TheUnknownAlias/betr_kicad_resources/README.md

# KiCad Component Library

This repository contains shared KiCad symbols and footprints for our projects.

## Structure
- `symbols/`: Contains schematic symbol libraries (.lib files)
- `footprints/`: Contains footprint libraries (.pretty folders)
- `3dmodels/`: Optional 3D models for components

## Usage
1. Clone this repository
2. In KiCad:
  - For symbols: Preferences → Manage Symbol Libraries → Add path to .lib files
  - For footprints: Preferences → Manage Footprint Libraries → Add path to .pretty folders

## Contributing
Please follow our contribution guidelines when adding new components.
