TheUnknownAlias/betr_kicad_resources/BOM_Files/Final_BOM.xls

Item # | Qty | Ref Des | Description/Value | MfgPartNum1 | Manufacturer 1 | MfgPartNum2 | Manufacturer 2 | MfgPartNum3 | Manufacturer 3 | Type
1 | 1 | C2001 | 4.7nF 0603 Form Factor Capacitor | 0603B472K500SD | NextGen Components |  |  |  |  | SMT
2 | 12 | C2002,C2005,C2007,C2008,C2009, C2013,C2019,C2024,C3001,C5001, C6001,C6002 | 100nF 0603 Form Factor Capacitor | 0603B104J500XD | Aillen |  |  |  |  | SMT
3 | 5 | C2003,C2017,C3002,C4003,C5002 | 10uF 0603 Form Factor Capacitor | 0603W106K6R3XD | NextGen Components |  |  |  |  | SMT
4 | 2 | C2004,C2023 | 10uF 25V 0603 Form Factor Capacitor | 0603W106M250XD | Aillen |  |  |  |  | SMT
5 | 2 | C2006,C2010 | 1 nF 0603 Form Factor Capacitor | 0603N102J500SD | NextGen Components |  |  |  |  | SMT
6 | 1 | C2020 | 22nF 0603 Form Factor Capacitor | 0603B223K500SD | NextGen Components |  |  |  |  | SMT
7 | 1 | C2022 | 1uF 0603 Form Factor Capacitor | 0603W105K100XD | Aillen |  |  |  |  | SMT
8 | 1 | C4002 | 22uF 0603 Form Factor Capacitor | 0603W226M6R3XD | Aillen |  |  |  |  | SMT
9 | 2 | C5003,C5004 | 10uF 16V 0603 Form Factor Capacitor | 0603W106M160XD | Aillen |  |  |  |  | SMT
10 | 1 | C2012 | 2.2uF 0603 Form Factor Capacitor | 0603W225K160XD | Aillen |  |  |  |  | SMT
11 | 2 | C2014,C2015 | 1uF 0603 Form Factor Capacitor | 0603B105K100XD | Aillen |  |  |  |  | SMT
12 | 1 | D2001 | Yellow LED | APT1608YC | Kingbright |  |  |  |  | SMT
13 | 1 | D2002 | Green LED | HSMG-C190 | Broadcom Limited |  |  |  |  | SMT
14 | 1 | D2003 | TVS DIODE 5.5VWM SOT143B | PRTR5V0U2X,215 | Nexperia USA Inc. |  |  |  |  | SMT
15 | 1 | D2004 | DIODE SCHOTTKY 60V 2A SOD123W | PMEG6020AELRX | Nexperia USA Inc. |  |  |  |  | SMT
16 | 1 | D3001 | Green LED 0603 Form Factor | 150060GS75000 | Würth Elektronik |  |  |  |  | SMT
17 | 1 | D6002 | Red LED 1206 Form Factor | LTST-C150EKT | Lite-On Inc. |  |  |  |  | SMT
18 | 1 | FL2001 | FERRITE BEAD 100 OHM 0603 1LN | BLM18EG101TN1D | Murata Electronics |  |  |  |  | SMT
19 | 1 | IC2001 | Step Down Converter | MP2322GQH-Z | Monolithic Power Systems Inc. |  |  |  |  | SMT
20 | 1 | J1003 | Connector: DC supply; socket; male; XT60; 30A; 500V; PIN: 2; on | XT60PW-M | AMASS |  |  |  |  | THT
21 | 1 | J2001 | USB2.0 MICRO AB SMD | ZX62-AB-5PA_31_ | Hirose Electric Co Ltd |  |  |  |  | SMT
22 | 1 | J6001 | CONN MICRO SD CARD R/A SMD | 2908-05WB-MG | 3M |  |  |  |  | SMT
23 | 1 | L2001 | FIXED IND 3.3UH 1.2A 255MOHM SMD | MAKK2016T3R3M | Taiyo Yuden |  |  |  |  | SMT
24 | 1 | LED2001 | LED RGB 0404 SMD | SMLP34RGBN1W3 | Rohm Semiconductor |  |  |  |  | SMT
25 | 1 | P1001 | TERM BLK 2P SIDE ENT 5.08MM PCB | 282837-2 | TE Connectivity AMP Connectors |  |  |  |  | THT
26 | 1 | R1002 | 100 0603 Form Factor Resistor | CR0603AFX-1000EAS | Bourns Inc. |  |  |  |  | SMT
27 | 1 | R1003 | 1.2k 0603 Form Factor Resistor | CR0603-FX-1201ELF | Bourns Inc. |  |  |  |  | SMT
28 | 1 | R2001 | 1M 0603 Form Factor Resistor | CR0603-FX-1004ELF | Bourns Inc. |  |  |  |  | SMT
29 | 2 | R2002,R2003 | 330 0603 Form Factor Resistor | CR0603-FX-3300ELF | Bourns Inc. |  |  |  |  | SMT
30 | 4 | R2006,R2009,R2013,R2014 | 976k 0603 Form Factor Resistor | CR0603-FX-9763ELF | Bourns Inc. |  |  |  |  | SMT
31 | 4 | R2007,R2011,R2012,R6001 | 1k 0603 Form Factor Resistor | CR0603AFX-1001EAS | Bourns Inc. |  |  |  |  | SMT
32 | 1 | R2008 | 220k 0603 Form Factor Resistor | CR0603-FX-2203ELF | Bourns Inc. |  |  |  |  | SMT
33 | 4 | R3001,R3002,R3003,R3004 | 4.7k 0603 Form Factor Resistor | CR0603-FX-4701ELF | Bourns Inc. |  |  |  |  | SMT
34 | 1 | R4002 | 19.1k 0603 Form Factor Resistor | CR0603-FX-1912ELF | Bourns Inc. |  |  |  |  | SMT
35 | 2 | R4003,R4004 | 100k 0603 Form Factor Resistor | CR0603AFX-1003EAS | Bourns Inc. |  |  |  |  | SMT
36 | 1 | R4005 | 53.6k 0603 Form Factor Resistor | CR0603-FX-5362ELF | Bourns Inc. |  |  |  |  | SMT
37 | 1 | SW2001 | Button | B3U-1000PM | Omron Electronics Inc-EMC Div |  |  |  |  | SMT
38 | 1 | U1005 | IC INST AMP 1 CIRCUIT 8DIP | AD623ANZ | Analog Devices |  |  |  |  | THT
39 | 1 | U2001 | Bluetooth® Low Energy 5.0 Module | NINA-B306-00B | u-blox |  |  |  |  | SMT
40 | 1 | U2002 | IMU Sensor | BMI270 | Bosch Sensortec |  |  |  |  | SMT
41 | 1 | U2003 | Magnetometer IC | BMM350 | Bosch Sensortec |  |  |  |  | SMT
42 | 1 | U2004 | MOSFET N-CH 60V 115MA SOT-523 | 2N7002T-7-F | Diodes Incorporated |  |  |  |  | SMT
43 | 1 | U3001 | IC DAC 12BIT V-OUT 10MSOP | MCP4728-E/UN | Microchip Technology |  |  |  |  | SMT
44 | 1 | U4001 | DC DC CONVERTER 0.8-18.48V | MPM3610GQV-P | Monolithic Power Systems Inc. |  |  |  |  | SMT
45 | 1 | U5001 | Stepper Motor Driver | DRV8833PWP | Texas Instruments |  |  |  |  | SMT
46 | 1 | U6001 | IC BUFFER NON-INVERT 6V 16-SOIC | CD74HC4050M96 | Texas Instruments |  |  |  |  | SMT
47 | 1 | U6002 | IC REG LINEAR 3.3V 150MA SOT23-5 | LP2985-33DBVR | Texas Instruments |  |  |  |  | SMT
48 | 1 | U2005 | IC REG LINEAR 1.8V 300MA SOT23-5 | TPS7A2018PDBVR | Texas Instruments |  |  |  |  | SMT
