TheUnknownAlias/betr_kicad_resources/KiCadFiles_Multimodal_Actuator_mk2/Multimodal_Actuator_mk2_mockup.step

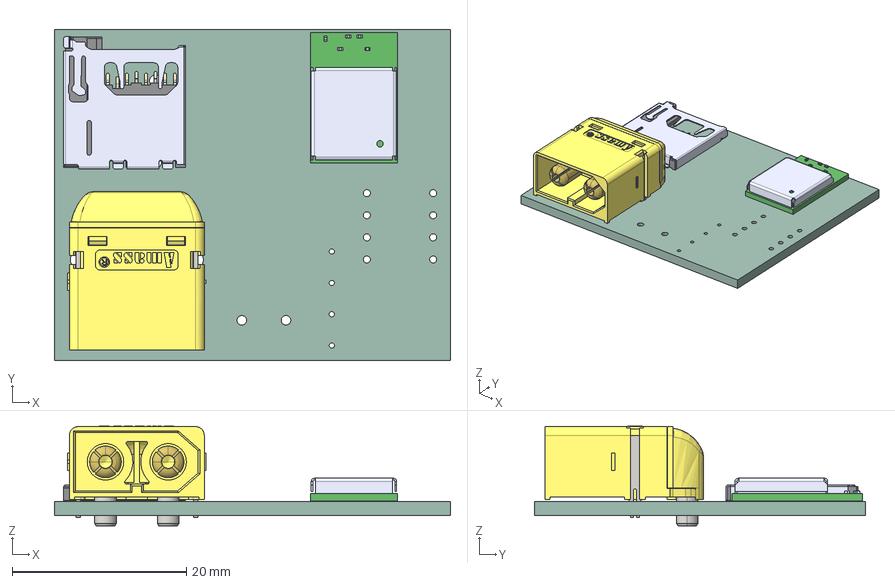
[picture p1: CAD file, 2025-09-09]
KiCadFiles_Multimodal_Actuator_mk2/Multimodal_Actuator_mk2_mockup.step
45.5 x 38.0 x 11.5 mm
2908-05WB-MG
NINA-B306-00B-00
XT60PW-M
_autosave-Multimodal_Actuator_mk2_PCB
