TheUnknownAlias/betr_kicad_resources/3dmodels/BMM150.STEP

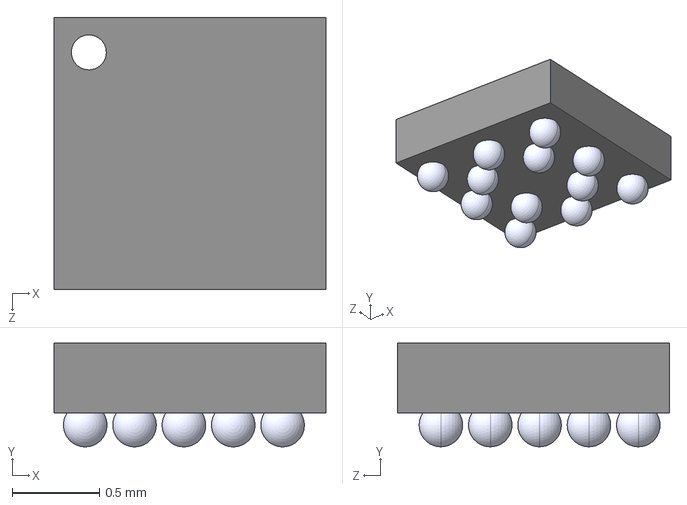
[picture p2: CAD file, 2025-09-09]
3dmodels/BMM150.STEP
1.56 x 0.595 x 1.56 mm
Body^BMM150
Pin^BMM150 x 12
