TheUnknownAlias/betr_kicad_resources/3dmodels/XT60PW-M.stp

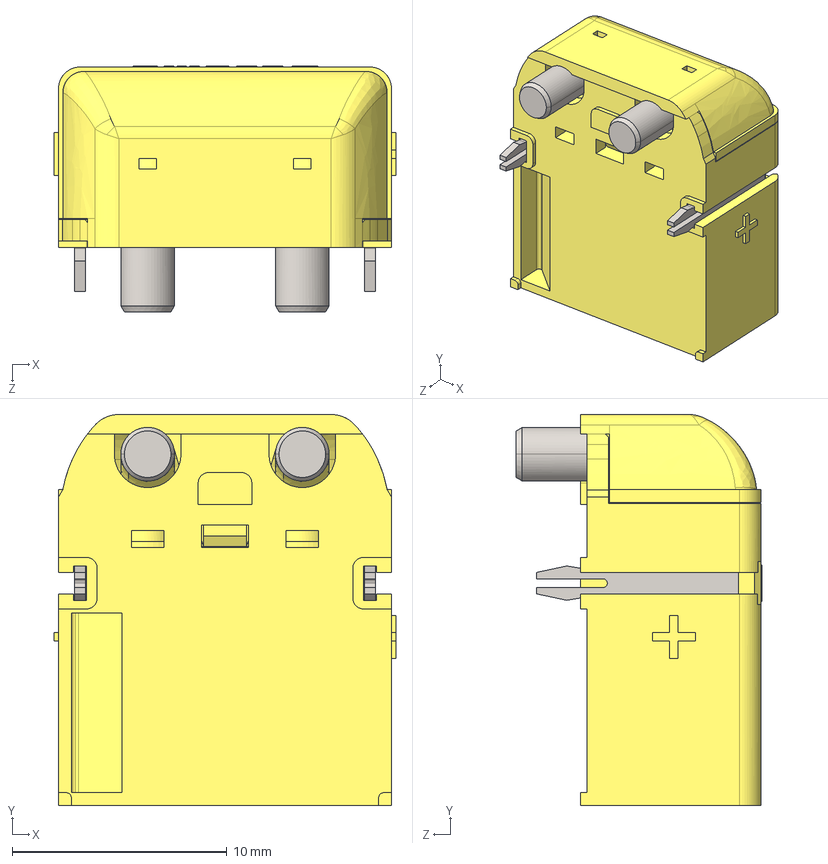
[picture p3: CAD file, 2025-09-09]
3dmodels/XT60PW-M.stp
15.9 x 18.2 x 11.5 mm
