TheUnknownAlias/betr_kicad_resources/3dmodels/BMI270.step

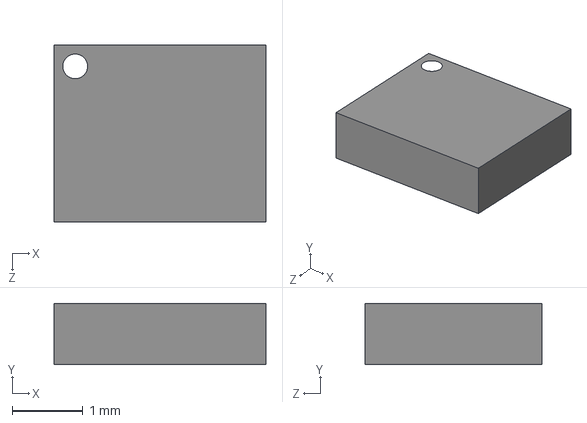
[picture p4: CAD file, 2025-09-09]
3dmodels/BMI270.step
3.00 x 0.87 x 2.50 mm
