TheUnknownAlias/betr_kicad_resources/3dmodels/MPM3606AGQV.step

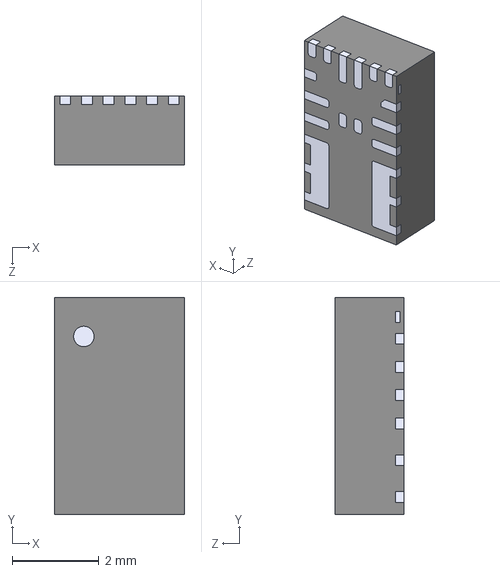
[picture p5: CAD file, 2025-09-09]
3dmodels/MPM3606AGQV.step
3.00 x 5.00 x 1.60 mm
