TheUnknownAlias/betr_kicad_resources/3dmodels/CD74HC4050M96.step

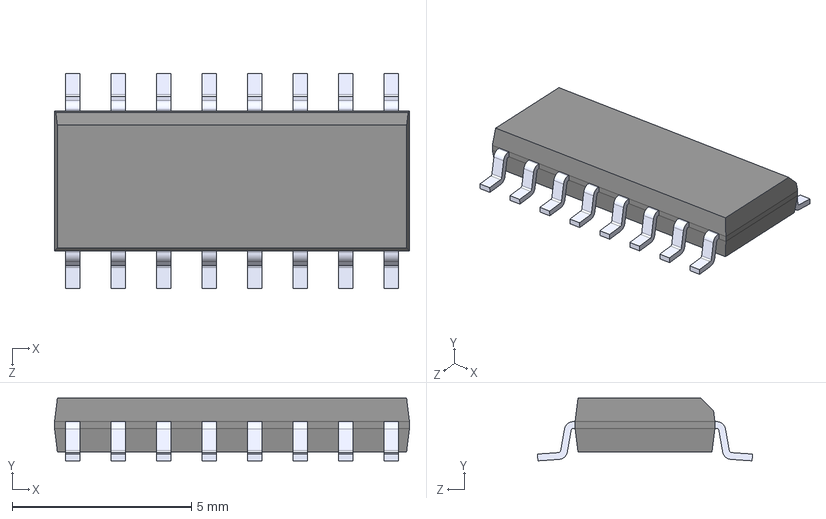
[picture p6: CAD file, 2025-09-09]
3dmodels/CD74HC4050M96.step
9.90 x 1.75 x 6.00 mm
