TheUnknownAlias/betr_kicad_resources/3dmodels/MP2322GQH-Z.stp

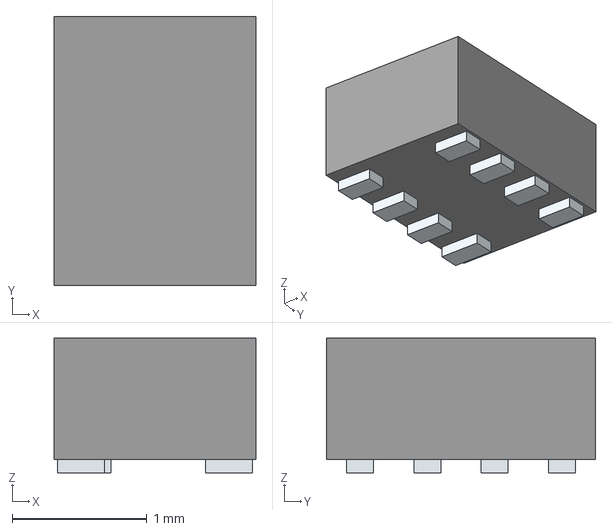
[picture p7: CAD file, 2025-09-09]
3dmodels/MP2322GQH-Z.stp
1.50 x 2.00 x 1.00 mm
Pins
