TheUnknownAlias/betr_kicad_resources/3dmodels/HSMG-C190.STEP

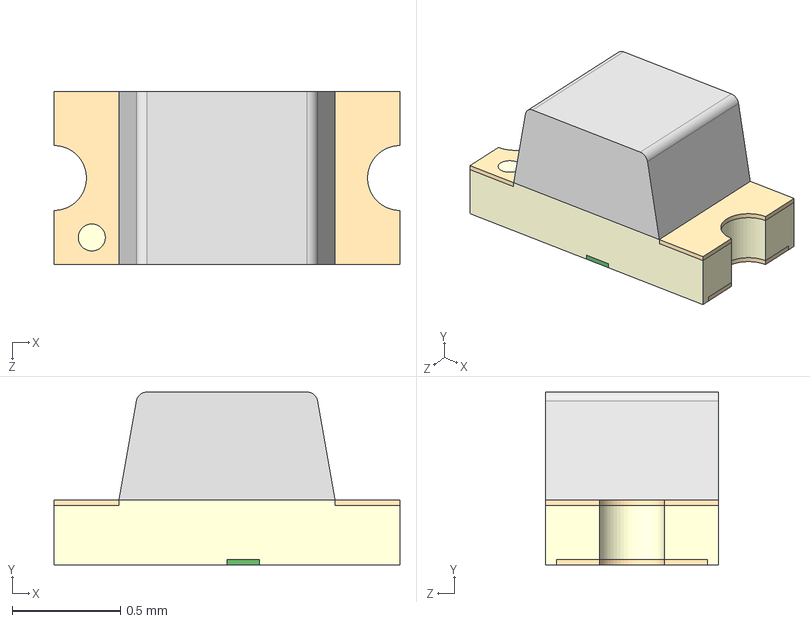
[picture p8: CAD file, 2025-09-09]
3dmodels/HSMG-C190.STEP
1.60 x 0.8 x 0.8 mm
