TheUnknownAlias/betr_kicad_resources/3dmodels/2N7002T-7-F.step

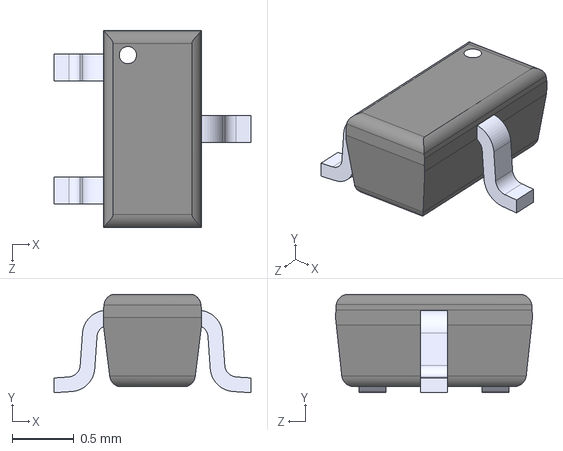
[picture p9: CAD file, 2025-09-09]
3dmodels/2N7002T-7-F.step
1.60 x 0.8 x 1.60 mm
