TheUnknownAlias/betr_kicad_resources/3dmodels/ZX62-AB-5PA(31).STEP

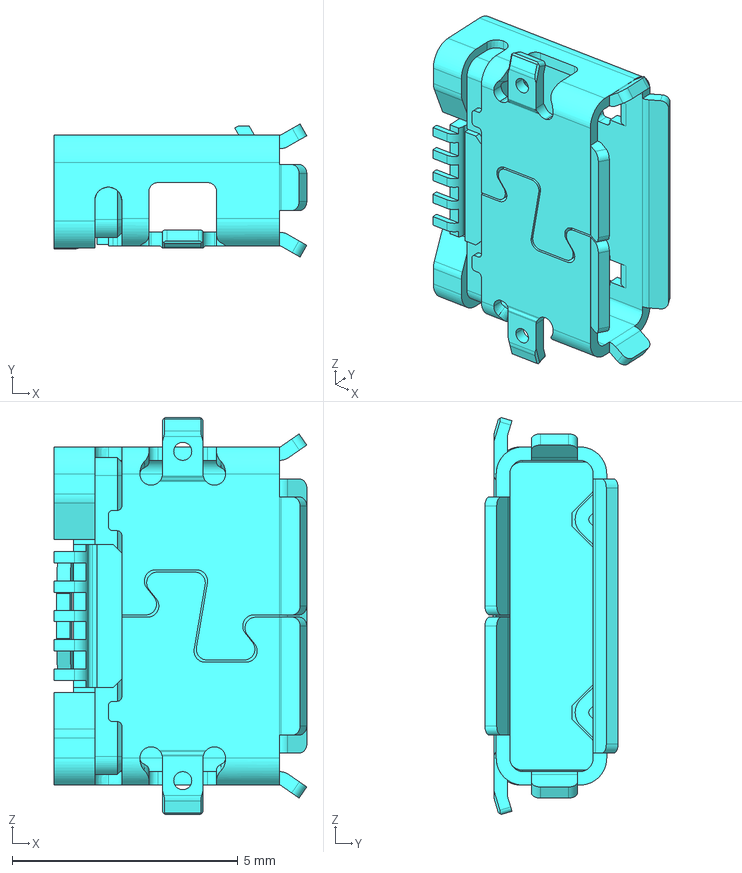
[picture p10: CAD file, 2025-09-09]
3dmodels/ZX62-AB-5PA(31).STEP
5.60 x 2.95 x 8.80 mm
