TheUnknownAlias/betr_kicad_resources/3dmodels/2908-05WB-MG.STEP

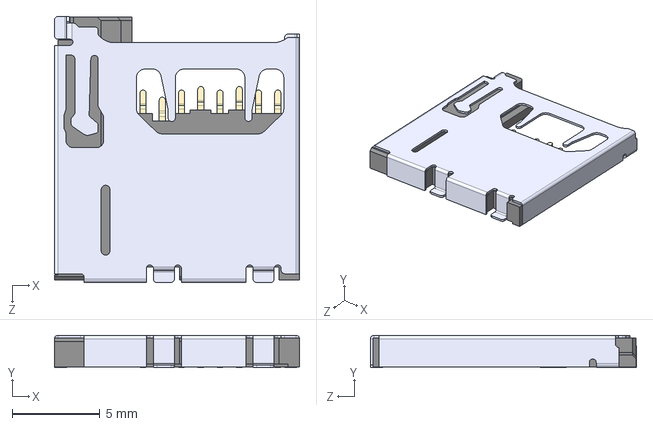
[picture p11: CAD file, 2025-09-09]
3dmodels/2908-05WB-MG.STEP
14.0 x 1.85 x 15.2 mm
