TheUnknownAlias/betr_kicad_resources/3dmodels/LP2985-33DBVR.step

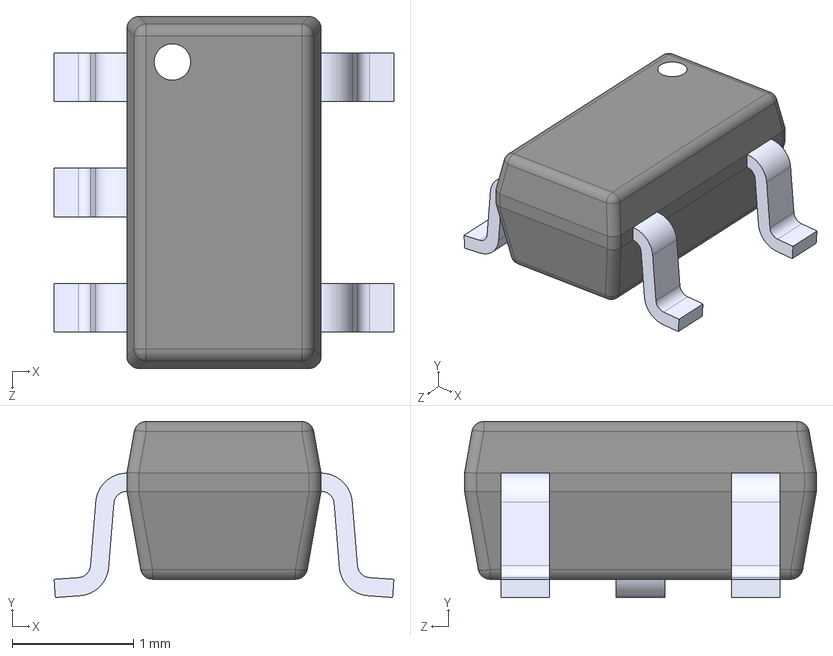
[picture p12: CAD file, 2025-09-09]
3dmodels/LP2985-33DBVR.step
2.80 x 1.45 x 2.90 mm
