TheUnknownAlias/betr_kicad_resources/3dmodels/APDS-9960.step

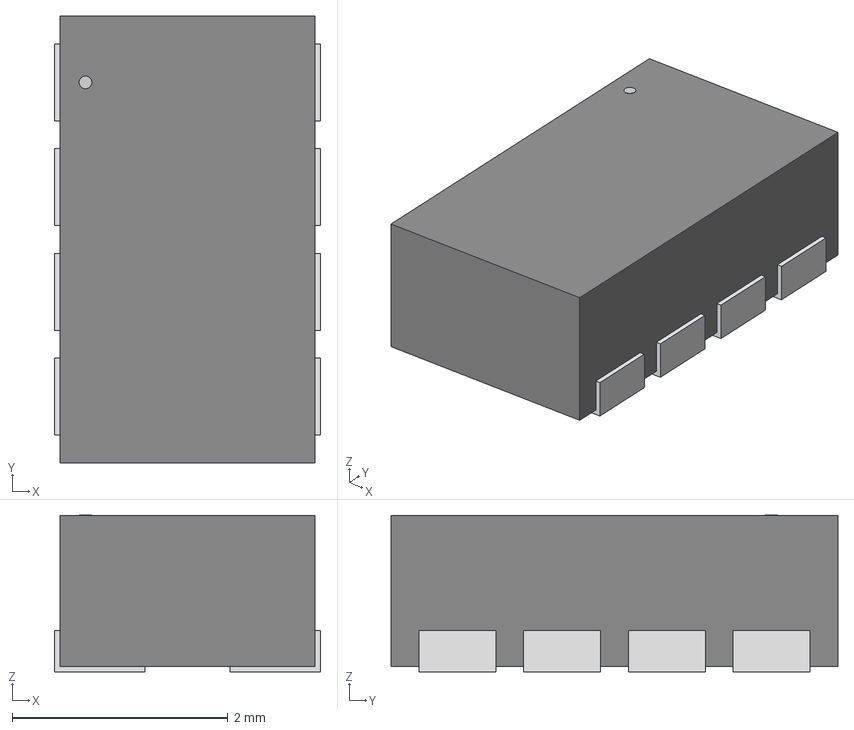
[picture p13: CAD file, 2025-09-09]
3dmodels/APDS-9960.step
2.46 x 4.14 x 1.45 mm
