TheUnknownAlias/betr_kicad_resources/3dmodels/B3U-1000PM_OMR.step

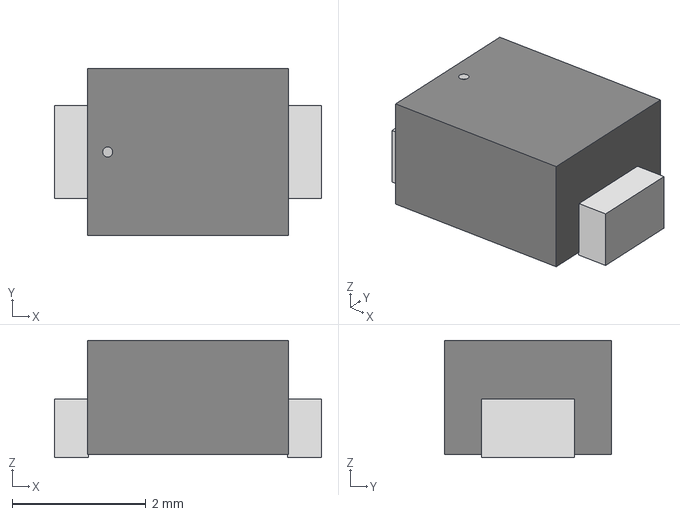
[picture p14: CAD file, 2025-09-09]
3dmodels/B3U-1000PM_OMR.step
3.99 x 2.49 x 1.75 mm
