TheUnknownAlias/betr_kicad_resources/3dmodels/NINA-B306-00B.step

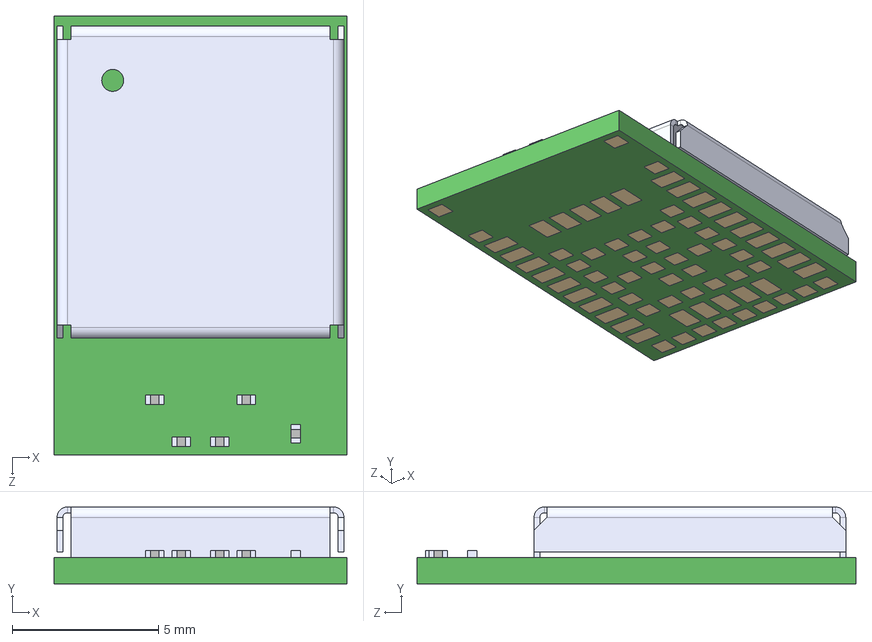
[picture p15: CAD file, 2025-09-09]
3dmodels/NINA-B306-00B.step
10.0 x 2.63 x 15.0 mm
