TheUnknownAlias/betr_kicad_resources/3dmodels/MAKK2016T3R3M.step

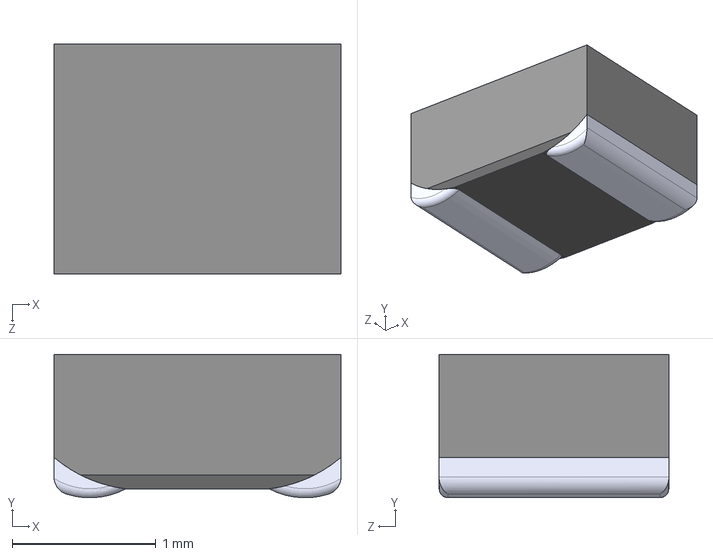
[picture p16: CAD file, 2025-09-09]
3dmodels/MAKK2016T3R3M.step
2.00 x 1 x 1.60 mm
