TheUnknownAlias/betr_kicad_resources/3dmodels/BEADC1608X65N.step

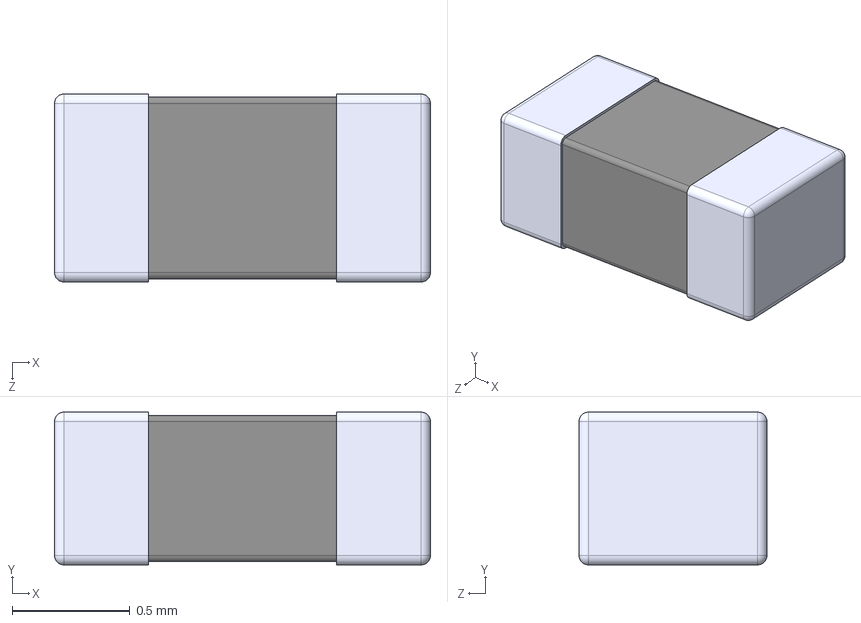
[picture p17: CAD file, 2025-09-09]
3dmodels/BEADC1608X65N.step
1.60 x 0.65 x 0.8 mm
