TheUnknownAlias/betr_kicad_resources/3dmodels/PMEG6020AELRX.step

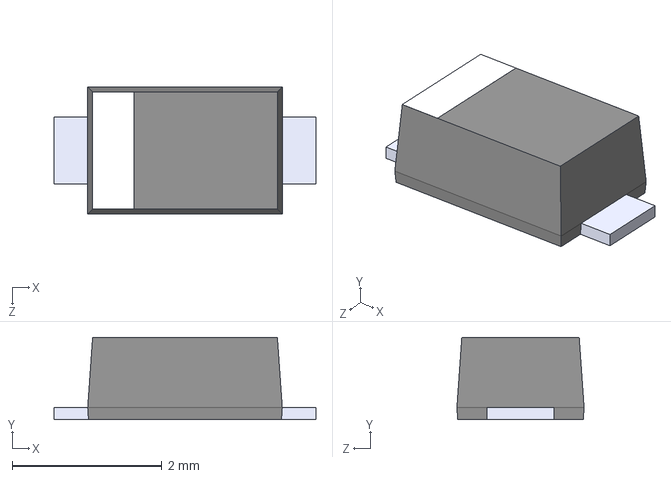
[picture p18: CAD file, 2025-09-09]
3dmodels/PMEG6020AELRX.step
3.50 x 1.10 x 1.70 mm
