TheUnknownAlias/betr_kicad_resources/3dmodels/MP34DT06JTR.STEP

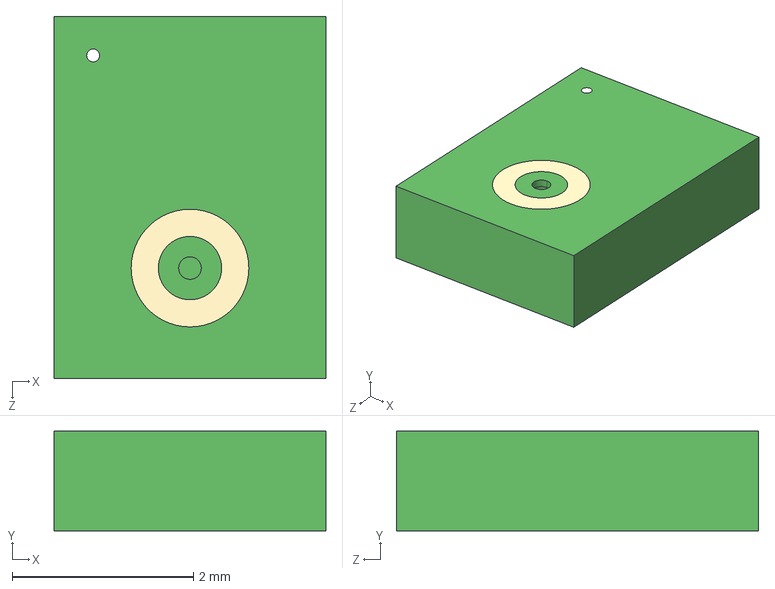
[picture p19: CAD file, 2025-09-09]
3dmodels/MP34DT06JTR.STEP
3.00 x 1.10 x 4.00 mm
