TheUnknownAlias/betr_kicad_resources/3dmodels/APT1608YC.STEP

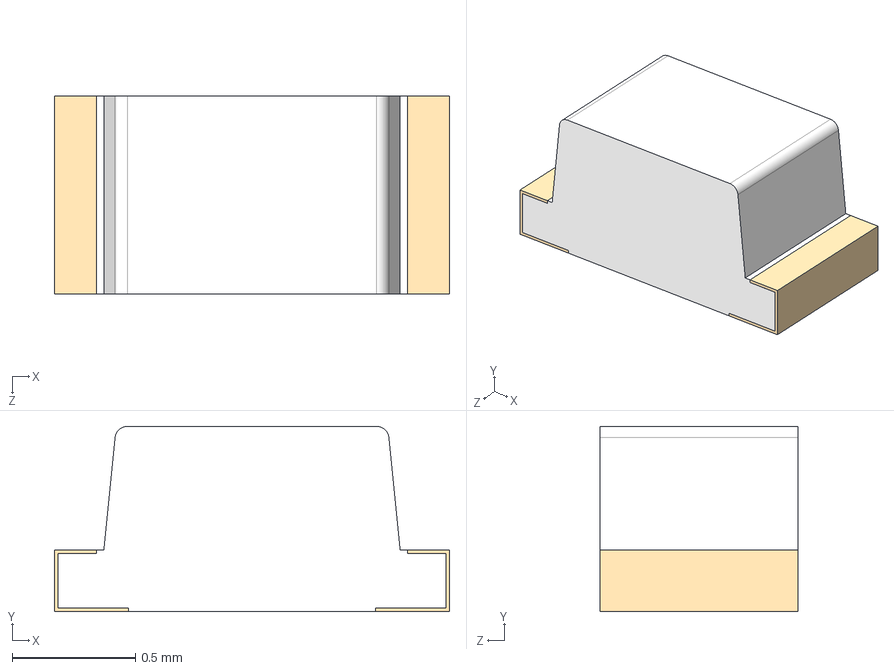
[picture p20: CAD file, 2025-09-09]
3dmodels/APT1608YC.STEP
1.60 x 0.75 x 0.8 mm
