TheUnknownAlias/betr_kicad_resources/3dmodels/LPS22HBTR.step

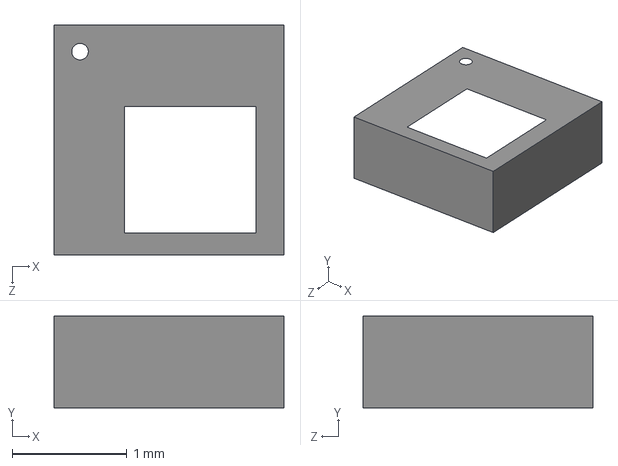
[picture p21: CAD file, 2025-09-09]
3dmodels/LPS22HBTR.step
2.00 x 0.8 x 2.00 mm
