TheUnknownAlias/betr_kicad_resources/(list of files, cad)

Other CAD files:
3dmodels/TPS7A2018PDBVR.step
3dmodels/282837-2.step
