TheUnknownAlias/betr_kicad_resources/KiCadFiles_Multimodal_Actuator_mk2/Multimodal_Actuator_mk2.kicad_pcb

## KiCad design KiCadFiles_Multimodal_Actuator_mk2/Multimodal_Actuator_mk2.kicad_pcb (2025-09-09)

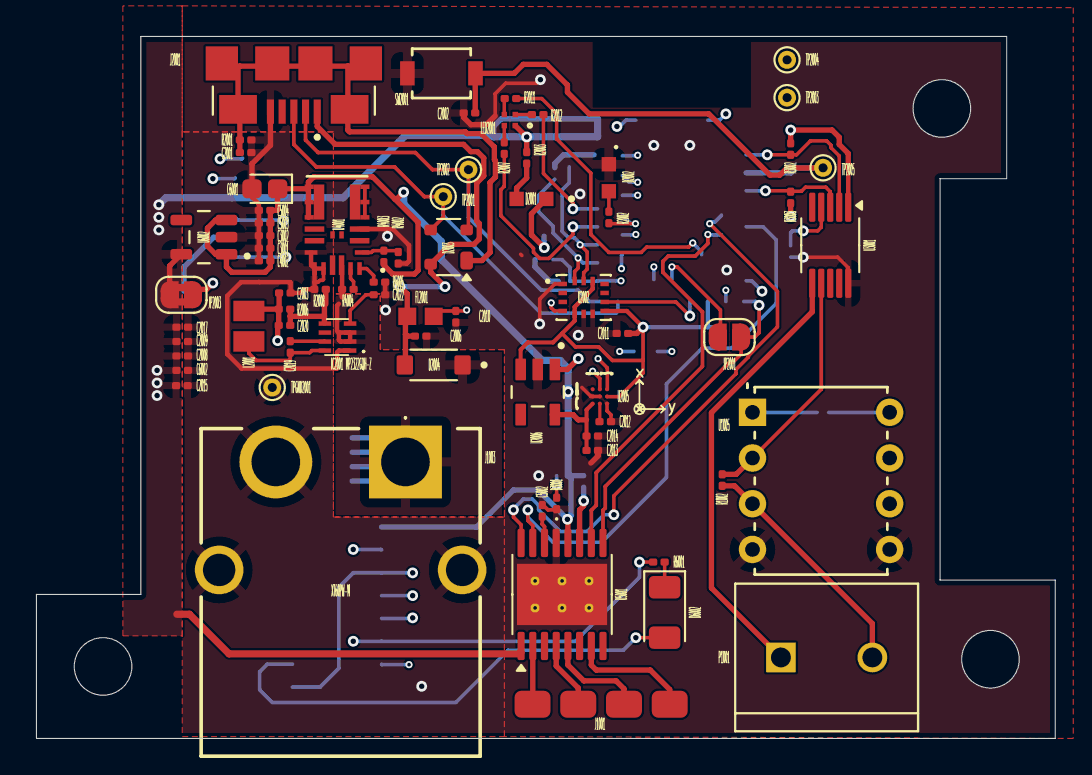
[picture p22: board Multimodal_Actuator_mk2.kicad_pcb from above]

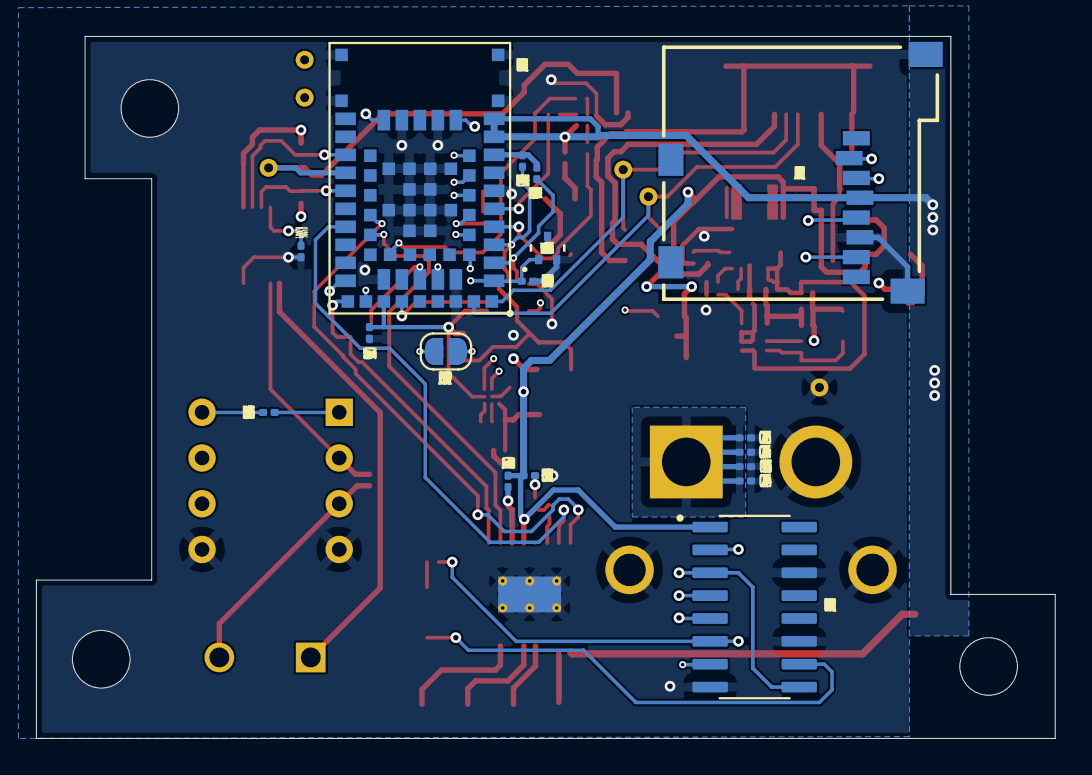
[picture p23: board Multimodal_Actuator_mk2.kicad_pcb from below]

Board: 4 copper layers, 56.6 x 39.0 mm, 91 parts (17 on the bottom side), 71 nets.

Parts:
C2001: 4.7 nF; C_0201_0603Metric
C2002, C2005, C2008, C2009, C2011, C2013: 100 nF; C_0201_0603Metric
C2003, C2017: 10 μF; C_0201_0603Metric
C2004, C2023: 10 μF 25V; C_0201_0603Metric
C2006, C2010: 1 nF; C_0201_0603Metric
C2012: 2.2uF; C_0201_0603Metric
C2014, C2015: 1uF; C_0201_0603Metric
C2019, C2024: 100 nF 50V; C_0201_0603Metric
C2020: 22 nF; C_0201_0603Metric
C2022: 1 μF; C_0201_0603Metric
C3001: 0.1uF; C_0201_0603Metric
C3002: 10uF; C_0201_0603Metric
C4002: 22μF; C_0201_0603Metric
C4003, C5002: 10μF; C_0201_0603Metric
C5001: 0.1μF; C_0201_0603Metric
C5003, C5004: 10μF/16V; C_0201_0603Metric
C6001: 100nF; CP_EIA-1608-08_AVX-J
C6002: 100nF; C_0201_0603Metric
D2001: APT1608YC; LED_APT1608YC
D2002: HSMG-C190
D2003: PRTR5V0U2X; SOT-143
D2004: PMEG6020AELRX; SODFL3517X110N
D3001: Green LED; LED_0201_0603Metric
D6002: LTST-C150EKT(RED_LED); LED_1206_3216Metric
FL2001: BLM18EG101TN1D; BEADC1608X65N
H1001, H1002, H1003: MountingHole; MountingHole_3.2mm_M3
IC2001: MP2322GQH-Z; MP2322GQHZ
J1001: Conn_01x04_Socket; 01x04_SMD_Connector_Linear
J1003: XT60PW-M; XT60PWM
J2001: ZX62-AB-5PA_31_; HIROSE_ZX62-AB-5PA_31_
J6001: 2908-05WB-MG; 3M_2908-05WB-MG
JP2001, JP2002: SolderJumper_2_Open; SolderJumper-2_P1.3mm_Open_RoundedPad1.0x1.5mm
JP2003: SolderJumper_2_Bridged; SolderJumper-2_P1.3mm_Bridged2Bar_RoundedPad1.0x1.5mm
L2001: MAKK2016T3R3M; INDC2016X100N
LED2001: SMLP34RGBN1W3; SMLP34_ROM
P1001: 282837-2; TE_282837-2
R1002: 100; R_0201_0603Metric
R1003: 1.2k; R_0201_0603Metric
R2001: 1M; R_0201_0603Metric
R2002, R2003: 330; R_0201_0603Metric
R2006, R2009, R2013, R2014: 976k; R_0201_0603Metric
R2007, R2011, R2012, R6001: 1k; R_0201_0603Metric
R2008: 220k; R_0201_0603Metric
R3001, R3002, R3003, R3004: 4.7kohm; R_0201_0603Metric
R4002: 19.1k; R_0201_0603Metric
R4003, R4004: 100k; R_0201_0603Metric
R4005: 53.6k; R_0201_0603Metric
SW2001: B3U-1000PM; B3U-1000PM_OMR
TP2001: D+; TestPoint_THTPad_D1.0mm_Drill0.5mm
TP2002: D-; TestPoint_THTPad_D1.0mm_Drill0.5mm
TP2003: SWDCLK; TestPoint_THTPad_D1.0mm_Drill0.5mm
TP2004: SWDIO; TestPoint_THTPad_D1.0mm_Drill0.5mm
TP2005: RESET; TestPoint_THTPad_D1.0mm_Drill0.5mm
TPGND2001: GND; TestPoint_THTPad_D1.0mm_Drill0.5mm
U1005: AD623ANZ; N_8_ADI
U2001: NINA-B306-00B; XCVR_NINA-B306-00B
U2002: BMI270; XDCR_BMI270
U2004: 2N7002T-7-F; SOT523_2N7002T_DIO
U2005: BMM350; BGA9_BMM350_BOS
U2006: TPS7A2018PDBVR; SOT95P280X145-5N
U3001: MCP4728; MSOP-10_3x3mm_P0.5mm
U4001: MPM3610GQV-P; QFN3p0x5p0x1p6_MPM3610_MNP
U5001: DRV8833PWP; HTSSOP-16-1EP_4.4x5mm_P0.65mm_EP3.4x5mm_Mask2.46x2.31mm_The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
U6001: CD74HC4050M96; SOIC127P600X175-16N
U6002: LP2985-33DBVR; SOT95P280X145-5N

Connections:
+3.3V: C2008.1, C2009.1, C2015.1, C2017.2, C6002.1, J6001.4 (VDD), JP2003.2 (B), LED2001.1, R2003.1, U2001.9 (VCC_IO), U2001.10 (VCC), U2006.1 (IN), U5001.1 (~SLEEP), U6002.5 (VOUT)
/AIN1: U2001.40 (GPIO_40), U5001.16 (AIN1)
/AIN2: U2001.22 (GPIO_22), U5001.15 (AIN2)
/Arduino_nano_Rev2/1.8VOUT: C2013.1, C2014.1, U2005.C1 (VDD), U2006.5 (OUT)
/Arduino_nano_Rev2/BMI270_INT1: U2001.32 (TRACE_D2/GPIO_32), U2002.4 (INT1)
/Arduino_nano_Rev2/BMI270_INT2: U2001.50 (QSPI_D0/GPIO_50), U2002.9 (INT2)
/Arduino_nano_Rev2/D8: JP2002.2 (B), U2001.48 (QSPI_D1/GPIO_48)
/Arduino_nano_Rev2/LB: R2011.2, U2001.43 (GPIO_43)
/Arduino_nano_Rev2/LG: R2007.2, U2001.4 (GPIO_4)
/Arduino_nano_Rev2/LR: R2012.2, U2001.5 (GPIO_5)
/Arduino_nano_Rev2/RESETN: C2002.1, SW2001.2, TP2005.1, U2001.19 (~RESET)
/Arduino_nano_Rev2/R_PULLUP: R2013.1, R2014.1, U2001.8 (SWO/TRACE_D0/GPIO_8)
/Arduino_nano_Rev2/SCL1: R2013.2, U2001.3 (GPIO_3), U2002.13 (SCX), U2005.A3 (SCK)
/Arduino_nano_Rev2/SDA1: R2014.2, U2001.2 (GPIO_2), U2002.14 (SDX), U2005.A2 (SDA)
/Arduino_nano_Rev2/USB_SHIELD: C2001.2, D2003.1 (GND), J2001.S1 (SHIELD), J2001.S2 (SHIELD__1), J2001.S3 (SHIELD__2), J2001.S4 (SHIELD__3), J2001.S5 (SHIELD__4), J2001.S6 (SHIELD__5), R2001.1
/BIN1: JP2001.2 (B), U2001.47 (QSPI_D3/GPIO_47), U5001.9 (BIN1)
/BIN2: U2001.41 (GPIO_41), U5001.10 (BIN2)
/CLK: R2009.1, U2001.1 (GPIO_1), U2004.1 (G), U6001.3 (1A), U6001.9 (4A)
/CS: U2001.36 (GPIO_36), U6001.7 (3A)
/DI: U2001.35 (GPIO_35), U6001.5 (2A)
/DO: J6001.7 (DATA_OUT), U2001.34 (GPIO_34)
/DRV8833/AOUT1: J1001.1, U5001.2 (AOUT1)
/DRV8833/AOUT2: J1001.2, U5001.4 (AOUT2)
/DRV8833/BOUT1: J1001.3, U5001.7 (BOUT1)
/DRV8833/BOUT2: J1001.4, U5001.5 (BOUT2)
/InAmpOutput: U1005.6 (OUTPUT), U2001.25 (GPIO_25)
/MCP4728_Quad_DAC/LDAC: R3004.2, U3001.4 (~LDAC)
/MPM3610_5V_Buck/EN: R4004.1, U4001.17 (EN)
/SCL: R3002.2, U2001.18 (GPIO_18), U3001.2 (SCL)
/SDA: R3003.2, U2001.20 (GPIO_20), U3001.3 (SDA)
/VA: P1001.1, U3001.6 (VOUTA)
/VB: R1002.2, U1005.2 (-IN), U3001.7 (VOUTB)
GND: C2001.1, C2002.2, C2003.1, C2004.2, C2005.1, C2006.2, C2008.2, C2009.2, C2010.2, C2011.2, C2012.1, C2013.2, C2014.2, C2015.2, C2017.1, C2022.2, C2023.2, C2024.2, C3001.2, C3002.2, C4002.2, C4003.2, C5002.2, C5003.2, C5004.2, C6001.2, C6002.2, D2002.C, D3001.1 (K), IC2001.1 (GND), J1003.2, J1003.3 (MH1), J1003.4 (MH2), J2001.5 (GND), J6001.6 (VSS), J6001.9 (GND), J6001.10 (GND), R2001.2, R2008.2, R2009.2, R3004.1, R4002.2, R4005.1, SW2001.1, TPGND2001.1, U1005.4 (-VS), U1005.5 (REF), U2001.6 (GND), U2001.12 (GND__1), U2001.14 (GND__2), U2001.26 (GND__3), U2001.30 (GND__4), U2001.53 (GND__5), U2001.EAGP1 (EAGP), U2001.EAGP2 (EAGP__1), U2001.EAGP3 (EAGP__2), U2001.EAGP4 (EAGP__3), U2001.EGP1 (EGP), U2001.EGP2 (EGP__1), U2001.EGP3 (EGP__2), U2001.EGP4 (EGP__3), U2001.EGP5 (EGP__4), U2001.EGP6 (EGP__5), U2001.EGP7 (EGP__6), U2001.EGP8 (EGP__7), U2001.EGP9 (EGP__8), U2001.EGP10 (EGP__9), U2001.EGP11 (EGP__10), U2001.EGP12 (EGP__11), U2002.1 (SDO), U2002.6 (GNDIO), U2002.7 (GND), U2004.2 (S), U2005.B1 (GND), U2005.B2 (ADSEL), U2005.C3 (BYPASS), U2006.2 (GND), U3001.10 (VSS), U4001.3 (AGND), U4001.12 (PGND), U4001.13 (PGND), U4001.14 (PGND), U5001.13 (GND), U5001.17 (GND), U6001.8 (GND), U6001.11 (5A), U6001.14 (6A), U6002.2 (GND)
unnamed: D2001.2, R2003.2
unnamed: D2002.A, R2002.2
unnamed: D2003.2 (I/O1), J2001.2 (D-), TP2002.1, U2001.55 (USB_DM)
unnamed: D2003.3 (I/O2), J2001.3 (D+), TP2001.1, U2001.54 (USB_DP)
unnamed: D3001.2 (A), R3001.2
unnamed: D6002.2 (A), U6001.10 (4Y)
unnamed: D6002.1 (K), R6001.1
unnamed: C2019.2, IC2001.7 (BST)
unnamed: C2020.2, IC2001.5 (FB), R2006.1, R2008.1
unnamed: C2019.1, IC2001.8 (SW), L2001.2
unnamed: C2022.1, IC2001.4 (VCC)
unnamed: J6001.2 (CS), R6001.2, U6001.6 (3Y)
unnamed: J6001.3 (DATA_IN), U6001.4 (2Y)
unnamed: J6001.5 (SCLK), U6001.2 (1Y)
unnamed: JP2001.1 (A), U2001.28 (NFC1/GPIO_28)
unnamed: JP2002.1 (A), U2001.29 (NFC2/GPIO_29)
unnamed: C2003.2, C2020.1, JP2003.1 (A), L2001.1, R2006.2
unnamed: LED2001.2, R2012.1
unnamed: LED2001.3, R2011.1
unnamed: LED2001.4, R2007.1
unnamed: P1001.2, R1002.1, U1005.3 (+IN)
unnamed: R1003.2, U1005.8 (+RG)
unnamed: R1003.1, U1005.1 (-RG)
unnamed: TP2003.1, U2001.11 (SWDCLK)
unnamed: TP2004.1, U2001.15 (SWDIO)
unnamed: R2002.1, U2001.33 (TRACE_D3/GPIO_33)
unnamed: C2010.1, FL2001.2, U2001.31 (VBUS)
unnamed: D2001.1, U2004.3 (D)
unnamed: C2012.2, U2005.C2 (CRST)
unnamed: R4005.2, U4001.18 (AAM)
unnamed: R4002.1, R4003.2, U4001.1 (FB)
unnamed: U4001.4 (SW), U4001.5 (SW), U4001.6 (SW)
unnamed: C5001.1, U5001.11 (VCP)
unnamed: C5002.1, U5001.14 (VINT)
VCC: C3001.1, C3002.1, C4002.1, C5001.2, C5003.1, C5004.1, C6001.1, R3001.1, R3002.1, R3003.1, R4003.1, U1005.7 (+VS), U3001.1 (VDD), U4001.7 (OUT), U4001.8 (OUT), U4001.9 (OUT), U5001.12 (VM), U6001.1 (VCC), U6002.1 (VIN), U6002.3 (ON/~OFF)
VDD_ENV: C2005.2, C2011.1, U2001.49 (QSPI_D2/GPIO_49), U2002.5 (VDDIO), U2002.8 (VDD), U2002.12 (CSB), U2005.B3 (VDDIO), U2006.3 (EN)
VUSB: C2006.1, D2003.4 (VCC), D2004.A, FL2001.1, J2001.1 (VCC)
Vin: C2004.1, C2023.1, C2024.1, C4003.1, D2004.C, IC2001.2 (IN), IC2001.3 (EN), J1003.1, R4004.2, U4001.16 (IN)
